JSchneid850/tetrisBusinessCard/TetrisBusinessCardCode/alphabet.cpp

#ifndef ALPHABET_H
#define ALPHABET_H

#include <array>
#include <iostream>
#include <ctime>

class Alphabet {
    public:
        using LetterMatrix = std::array<std::array<bool, 5>, 5>;
        
        static std::array<LetterMatrix, 3> getBinaryInitials(std::array<char, 3> initials, bool useCentered) {
            std::array<LetterMatrix, 3> binaryInitials = {{false}};

            for (size_t i = 0; i < 3; ++i) {
                if(useCentered){
                    binaryInitials[i] = Alphabet::alphabet[initials[i] - 'A'];
                } else {
                    binaryInitials[i] = Alphabet::centeredAlphabet[initials[i] - 'A'];
                }
            }
            return binaryInitials;
        }

        static constexpr std::array<std::array<bool, 5>, 5> caret = {{
            //^    
                {0,0,0,0,0},
                {0,0,1,0,0},
                {0,1,0,1,0},
                {1,0,0,0,1},
                {0,0,0,0,0}   
        }};

                                                         // A  B  C  D  E  F  G  H  I  J  K  L  M  N  O  P  Q  R  S  T  U  V  W  X  Y  Z
        static constexpr std::array<int, 26> letterWidth = {3, 3, 3, 3, 3, 3, 4, 3, 1, 3, 4, 3, 5, 4, 3, 3, 4, 4, 3, 3, 3, 3, 5, 3, 3, 4};

            static constexpr std::array<std::array<std::array<bool, 5>, 5>, 26> centeredAlphabet = {{
            // A
            {{
                {0,0,1,0,0},
                {0,1,0,1,0},
                {0,1,1,1,0},
                {0,1,0,1,0},
                {0,1,0,1,0}
            }},
            // B
            {{
                {0,1,1,0,0},
                {0,1,0,1,0},
                {0,1,1,0,0},
                {0,1,0,1,0},
                {0,1,1,0,0}
            }},
            // C
            {{
                {0,0,1,1,0},
                {0,1,0,0,0},
                {0,1,0,0,0},
                {0,1,0,0,0},
                {0,0,1,1,0}
            }},
            // D
            {{
                {0,1,1,0,0},
                {0,1,0,1,0},
                {0,1,0,1,0},
                {0,1,0,1,0},
                {0,1,1,0,0}
            }},
            // E
            {{
                {0,1,1,1,0},
                {0,1,0,0,0},
                {0,1,1,0,0},
                {0,1,0,0,0},
                {0,1,1,1,0}
            }},
            // F
            {{
                {0,1,1,1,0},
                {0,1,0,0,0},
                {0,1,1,0,0},
                {0,1,0,0,0},
                {0,1,0,0,0}
            }},
            // G
            {{
                {0,0,1,1,1},
                {0,1,0,0,0},
                {0,1,0,1,1},
                {0,1,0,0,1},
                {0,0,1,1,1}
            }},
            // H
            {{
                {0,1,0,1,0},
                {0,1,0,1,0},
                {0,1,1,1,0},
                {0,1,0,1,0},
                {0,1,0,1,0}
            }},
            // I
            {{
                {0,0,1,0,0},
                {0,0,1,0,0},
                {0,0,1,0,0},
                {0,0,1,0,0},
                {0,0,1,0,0}
            }},
            // J
            {{
                {0,0,0,1,0},
                {0,0,0,1,0},
                {0,0,0,1,0},
                {0,1,0,1,0},
                {0,0,1,0,0}
            }},
            // K
            {{
                {0,1,0,0,1,},
                {0,1,0,1,0,},
                {0,1,1,0,0,},
                {0,1,0,1,0,},
                {0,1,0,0,1,}
            }},
            // L
            {{
                {0,1,0,0,0},
                {0,1,0,0,0},
                {0,1,0,0,0},
                {0,1,0,0,0},
                {0,1,1,1,0}
            }},
            // M
            {{
                {1,0,0,0,1},
                {1,1,0,1,1},
                {1,0,1,0,1},
                {1,0,0,0,1},
                {1,0,0,0,1}
            }},
            // N
            {{
                {0,1,0,0,1},
                {0,1,1,0,1},
                {0,1,0,1,1},
                {0,1,0,0,1},
                {0,1,0,0,1}
            }},
            // O
            {{
                {0,0,1,0,0},
                {0,1,0,1,0},
                {0,1,0,1,0},
                {0,1,0,1,0},
                {0,0,1,0,0}
            }},
            // P
            {{
                {0,1,1,0,0},
                {0,1,0,1,0},
                {0,1,1,0,0},
                {0,1,0,0,0},
                {0,1,0,0,0}
            }},
            // Q
            {{
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
                {0,1,0,0,0},
                {0,1,0,0,0}
            }},
            // Z
            {{
                {1,1,1,1,0},
                {0,0,0,1,0},
                {0,0,1,0,0},
                {0,1,0,0,0},
                {1,1,1,1,0}
            }},
        }};
};

#endif
