JSchneid850/tetrisBusinessCard/TetrisBusinessCardCode/numbers.cpp

#include <array>
class Numbers{
    public:
        static constexpr std::array<int, 10> numberWidth = {3, 1, 3, 3, 3, 3, 3, 3, 3, 3};

        static constexpr std::array<std::array<std::array<bool, 3>, 5>, 10> number = {{
                //0
                {{
                    {true, true, true},
                    {true, false, true},
                    {true, false, true},
                    {true, false, true},
                    {true, true, true}, 
                }},
                //1
                {{
                    {false, false, true},
                    {false, false, true},
                    {false, false, true},
                    {false, false, true},
                    {false, false, true},
                }},
                //2
                {{
                    {true, true, true},
                    {false, false, true},
                    {true, true, true},
                    {true, false, false},
                    {true, true, true},
                }},
                //3
                {{
                    {true, true, true},
                    {false, false, true},
                    {true, true, true},
                    {false, false, true},
                    {true, true, true},
                }},
                //4
                {{
                    {true, false, true},
                    {true, false, true},
                    {true, true, true},
                    {false, false, true},
                    {false, false, true},
                }},
                //5
                {{
                    {true, true, true},
                    {true, false, false},
                    {true, true, true},
                    {false, false, true},
                    {true, true, true},
                }},
                //6
                {{
                    {true, true, true},
                    {true, false, false},
                    {true, true, true},
                    {true, false, true},
                    {true, true, true},
                }},
                //7
                {{
                    {true, true, true},
                    {false, false, true},
                    {false, false, true},
                    {false, false, true},
                    {false, false, true},
                }},
                //8
                {{
                    {true, true, true},
                    {true, false, true},
                    {true, true, true},
                    {true, false, true},
                    {true, true, true},
                }},
                //9
                {{
                    {true, true, true},
                    {true, false, true},
                    {true, true, true},
                    {false, false, true},
                    {true, true, true},
                }},
            }};
};
