JSchneid850/tetrisBusinessCard/(commit log)

2024-10-27 init commit
    [bom.csv, designators.csv, freerouting.dsn, positions.csv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]
2024-12-08 Clean up repo a bit and switch to cpp
    [tetrisBusinessCard-B_Cu.gbr, tetrisBusinessCard-B_Mask.gbr, tetrisBusinessCard-B_Paste.gbr, tetrisBusinessCard-B_Silkscreen.gbr, tetrisBusinessCard-Edge_Cuts.gbr, tetrisBusinessCard-F_Cu.gbr, tetrisBusinessCard-F_Mask.gbr, tetrisBusinessCard-F_Paste.gbr]
2024-12-10 Scaffold charlieplex driver
2024-12-10 start translating driver
2024-12-18 Add capacitive touch symbol and update PCB partially
    [tetrisBusinessCard.kicad_pcb, tetrisBusinessCard.kicad_sch]
2024-12-24 pcb rev0.2
    [tetrisBusinessCard.kicad_pcb, tetrisBusinessCard.kicad_sch]
2025-01-14 done refactoring driver to use 2d arrays
2025-01-18 Fixed vertical scanning! turns out Its not a hardware issue
    [TetrisBusinessCard.cpp, charlieplexDriver.cpp]
2025-01-21 Fix driver, now to write tetris
    [TetrisBusinessCard.cpp, charlieplexDriver.cpp]
2025-01-29 Fix Write frame issue and clean up usages of cstyle arrays in favor of std::array
    [TetrisBusinessCard.cpp, charlieplexDriver.cpp, matrix.cpp, playfield.cpp, shape.cpp]
2025-01-30 Here's buttons
2025-01-31 Still a few collision errors to figure out
    [TetrisBusinessCard.cpp, charlieplexDriver.cpp, matrix.cpp, playfield.cpp, shape.cpp]
2025-02-05 Now all I've got left is the score board!
2025-02-05 MVP done, now 1 more hardware revision to add back the battery
2025-03-15 RP2040 draws too much power. last commit before switching to stm32 based chips
    [bom.csv, designators.csv, positions.csv, tetrisBusinessCard.kicad_pcb, tetrisBusinessCard.kicad_sch]
2025-06-09 Fully Working Card. In need of a re-factor though I dont know what compelled me to not use .h files
    [designators.csv, freerouting.dsn, positions.csv, tetrisBusinessCard.kicad_pcb]
2025-08-08 Clean up files and push up final (Bugs not withstanding) version
    [Score.cpp, Scorecard.cpp, TetrisBusinessCard.cpp, alphabet.cpp, button.cpp, charlieplexDriver.cpp, matrix.cpp, numbers.cpp]
2026-06-28 update repo to be up to date with laptop backip
    [bom.csv, designators.csv, positions.csv, tetrisBusinessCard.kicad_pcb]
